Heavy-Vehicle-Networking-At-U-Tulsa/CAN-Data-Diode/docs/21.13.25.jpg

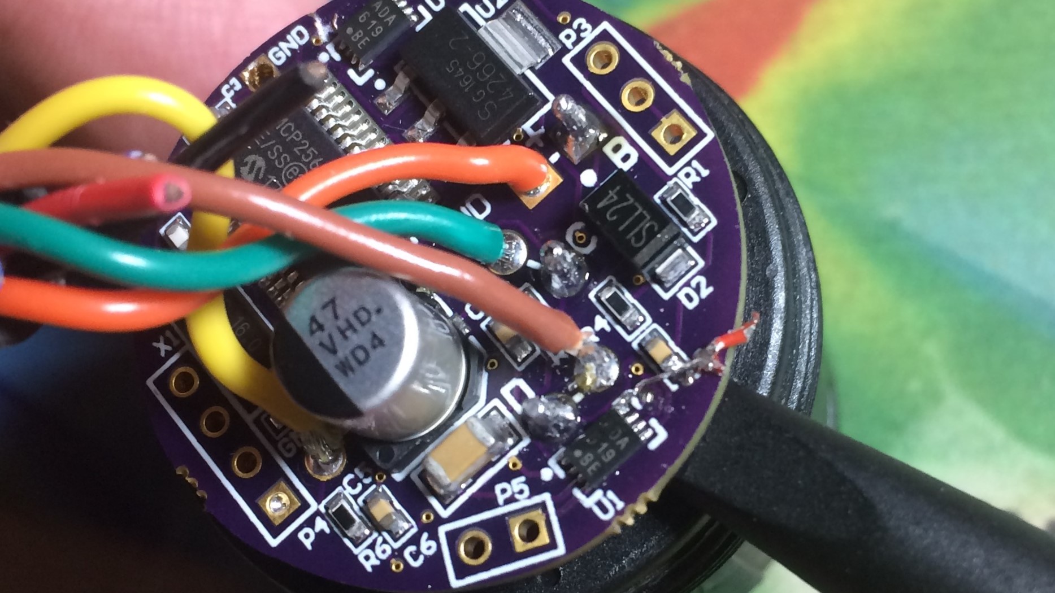
docs/21.13.25.jpg
