Heavy-Vehicle-Networking-At-U-Tulsa/CAN-Data-Diode/docs/Arduino Board Manager ATTiny Screen Capture.PNG

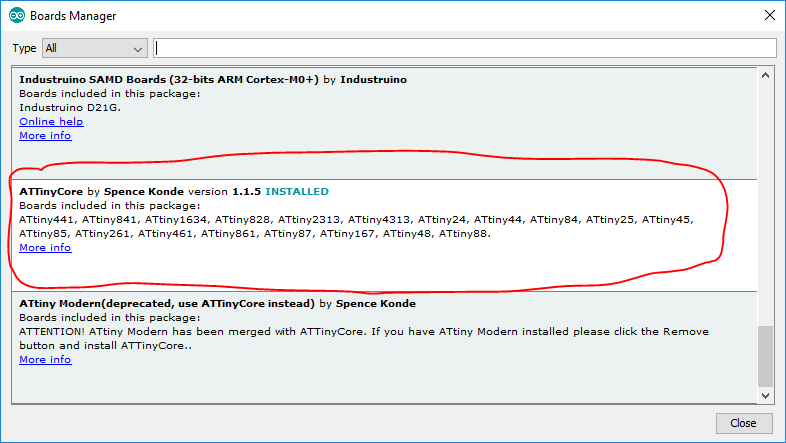
docs/Arduino Board Manager ATTiny Screen Capture.PNG
