Heavy-Vehicle-Networking-At-U-Tulsa/CAN-Data-Diode/docs/Arduino Manage Libraries Screen Capture.PNG

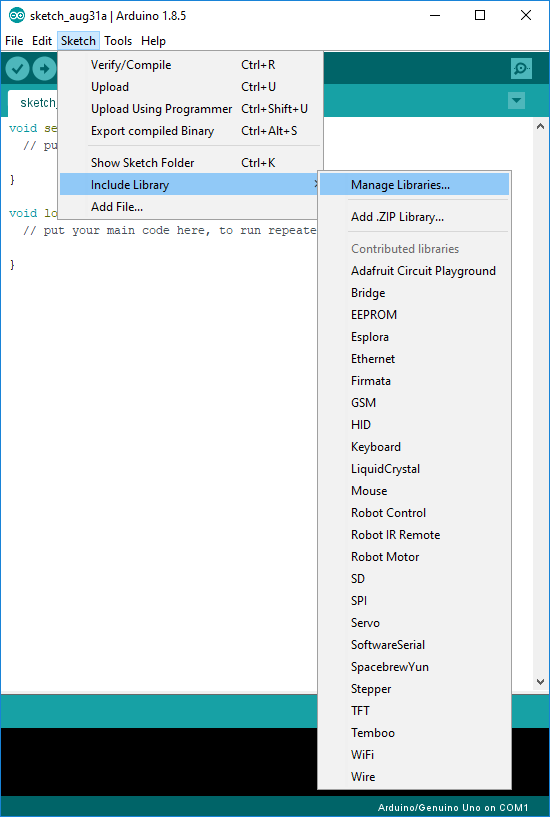
docs/Arduino Manage Libraries Screen Capture.PNG
