Heavy-Vehicle-Networking-At-U-Tulsa/CAN-Data-Diode/examples/Sleep_Test/Sleep_Test.ino

#include <avr/sleep.h>
#include <avr/power.h>
#include <avr/wdt.h>

#define LED_PIN (13)

volatile int f_wdt=1;



/***************************************************
 *  Name:        ISR(WDT_vect)
 *
 *  Returns:     Nothing.
 *
 *  Parameters:  None.
 *
 *  Description: Watchdog Interrupt Service. This
 *               is executed when watchdog timed out.
 *
 ***************************************************/
ISR(WDT_vect)
{
  if(f_wdt == 0)
  {
    f_wdt=1;
  }
}


/***************************************************
 *  Name:        enterSleep
 *
 *  Returns:     Nothing.
 *
 *  Parameters:  None.
 *
 *  Description: Enters the arduino into sleep mode.
 *
 ***************************************************/
void enterSleep(void)
{
  set_sleep_mode(SLEEP_MODE_PWR_DOWN); 
  sleep_enable();
  
  /* Now enter sleep mode. */
  sleep_mode();
  
  /* The program will continue from here after the WDT timeout*/
  sleep_disable(); /* First thing to do is disable sleep. */
  
  /* Re-enable the peripherals. */
  power_all_enable();
}



/***************************************************
 *  Name:        setup
 *
 *  Returns:     Nothing.
 *
 *  Parameters:  None.
 *
 *  Description: Setup for the serial comms and the
 *                Watch dog timeout. 
 *
 ***************************************************/
void setup()
{

  pinMode(LED_PIN,OUTPUT);

  /*** Setup the WDT ***/
  
  /* Clear the reset flag. */
  MCUSR &= ~(1<<WDRF);
  
  /* In order to change WDE or the prescaler, we need to
   * set WDCE (This will allow updates for 4 clock cycles).
   */
  WDTCR |= (1<<WDCE) | (1<<WDE);

  /* set new watchdog timeout prescaler value */
  WDTCR = 1<<WDP0 | 1<<WDP3; /* 8.0 seconds */
  
  /* Enable the WD interrupt (note no reset). */
  WDTCR |= _BV(WDIE);
}



/***************************************************
 *  Name:        enterSleep
 *
 *  Returns:     Nothing.
 *
 *  Parameters:  None.
 *
 *  Description: Main application loop.
 *
 ***************************************************/
void loop()
{
  if(f_wdt == 1)
  {
    /* Toggle the LED */
    digitalWrite(LED_PIN, !digitalRead(LED_PIN));
    
    /* Don't forget to clear the flag. */
    f_wdt = 0;
    
    /* Re-enter sleep mode. */
    enterSleep();
  }
  else
  {
    /* Do nothing. */
  }
}
