Heavy-Vehicle-Networking-At-U-Tulsa/CAN-Data-Diode/(commit log)

2018-03-11 Bit Banged SPI worked
2018-03-11 SPI Works, but is slow
2018-03-11 SPI transfer function works fast
2018-05-11 Added Low power basic code
2018-05-20 added Silent pin
2018-07-03 CAN seen on ELD Side
    Need to fix the clock output from ELD MCP25625 to the rest of the board.
2018-09-07 Initial Compile Commit with autobaud
    This is the first commit with auto baud in the arduino code. The last baudrate is read from EEPROM and CAN is checked at that baudrate.
2018-09-08 added SLEEP_MODE_PWR_SAVE for low power loop
    This will make the device every 8 seconds to check to see if the error count has increased at all.
    This is run by a watchdog timer and was done referencing http://donalmorrissey.blogspot.com/2010/04/sleeping-arduino-part-5-wake-up-via.html
    NOTE: the low power mode will not work with the watchdog timer according to spencekonde's write up
    [ELD_Side_with_error_check_LOW_POWER_WDT.ino]
2018-09-11 Creating a list of Well defined variable and removing magic numbers.
    Based off Ben's comments from his review I have removed magic perfect numbers and defined them globally
    I also got rid of the extra "test files" and am currently working only on this one branch. I understand making a pull request is typically done when read to merge with master. I should have waited for the original pull request.
2018-09-11 changed comments
    forgot to change the last set of ben's issues he borught up during his review. I changed a copy paste comment that I overlooked to actually describe what I am actually doing
    [ELD_Side_with_error_check_LOW_POWER_WDT.ino]
2018-09-11 Added "Currently working on"
    Added this to show what code I am wanting to have reviewed.
2018-09-12 Changed README.md
    I added more information to README.md and changed one word in the arduino sketchs from interrupt to interval to avoid confusion.
    [EEPROM_MAP.ino, ELD_Side_with_error_check_LOW_POWER_WDT.ino.ino]
2018-09-12 Added request messages
    I have added the ability to send request messages based on the WDT cycle value.
    In the event that the watchdog wakes the device up from sleep then the device will check to see if it is time to send the message, if not it will increment a counter. Upon sending, the counter will be reset to 0.
    Any offset in the message timing can be done by initializing the counters at a different value.
    [J1939.ino]
2018-09-12 Addressing Ben's concerns
    Fixed the issues that he brought up minus the extra function
    [ELD.ino, J1939.ino]
